ahsonnenschein/edm-fpga/Screenshot from EDM Controller.png

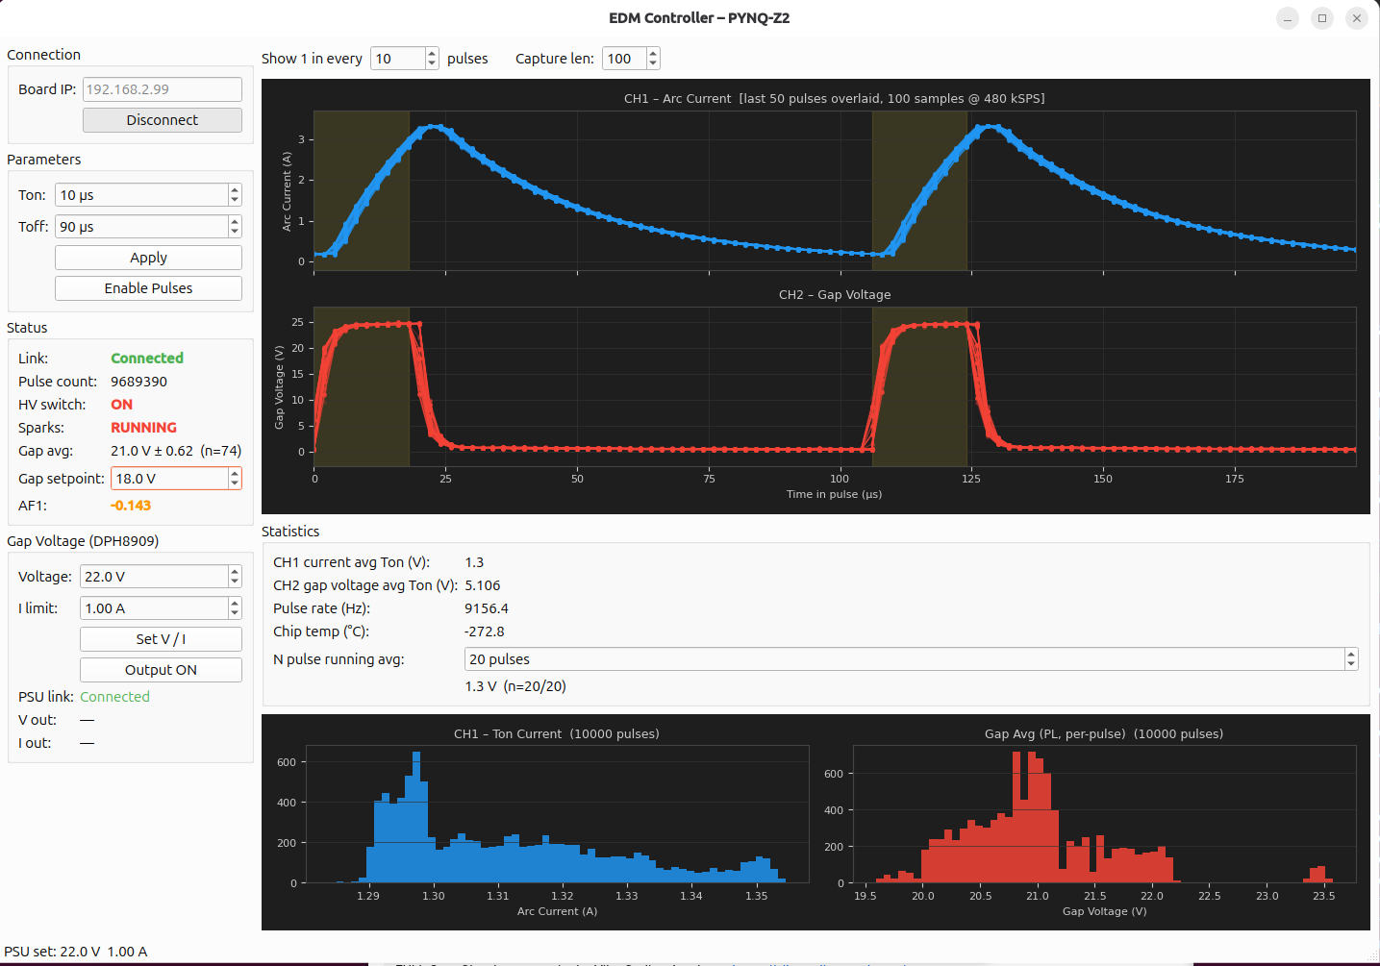
Screenshot from EDM Controller.png
