ahsonnenschein/edm-fpga/(commit log)

2026-03-14 Initial EDM FPGA controller for Red Pitaya STEMlab 125-14
    - edm_pulse_ctrl.v: Ton/Toff state machine, 1-cycle trigger output
    - waveform_capture.v: triggered ADC capture, AXI-Stream to DMA
    - axi_edm_regs.v: AXI-Lite register file (8 registers)
    - edm_top.v: top-level integration
    - create_project.tcl: Vivado block design (Zynq-7010, AXI DMA)
    - redpitaya_v1.xdc: pin constraints
    - modbus_server.py: Modbus TCP → AXI register bridge
    - waveform_manager.py: DMA reader, HDF5 save, matplotlib display
2026-03-14 Add simulation testbench — all tests passing
    - tb_edm_top.v: tests AXI-Lite R/W, pulse timing, waveform capture, disable
    - run_sim.tcl: xsim batch runner
    - synth_check.tcl: out-of-context synthesis check
    - Added `timescale 1ns/1ps to all RTL modules
    Simulation results:
    Ton = 10 cycles ✓
    Toff = 20 cycles ✓
    Waveform capture = 20 samples with correct TLAST ✓
    Disable stops pulse output ✓
    [axi_edm_regs.v, edm_pulse_ctrl.v, edm_top.v, tb_edm_top.v, waveform_capture.v]
2026-03-14 Add waveform streaming from RP to operator console (TCP port 5005)
    waveform_manager.py: WaveformServer broadcasts each decoded waveform
    frame to all connected consoles after every DMA transfer.
    operator_console.py: hardware mode now opens a second TCP connection
    to port 5005, receives frames, and feeds the live plots — simulation
    mode is unchanged.
    Wire protocol: [4-byte n_samples][n×float32 CH1][n×float32 CH2]
2026-03-28 Port EDM controller from Red Pitaya to PYNQ-Z2
    - Target changed to Zynq-7020 (xc7z020clg400-1), 100 MHz fabric clock
    - Replaced external 14-bit parallel ADC interface with XADC Wizard (AXI,
    VP/VN + VAUX1/Arduino A0 for gap voltage and arc current)
    - Added hv_enable input (Arduino D3) with 2-FF clock domain synchroniser;
    pulse output and pulse controller enable gated by hv_enable
    - Added warning lamp outputs (Arduino D4/D5/D6) with combinational
    green/orange/red logic based on hv_enable and enable register
    - Simplified AXI register map: removed waveform capture registers,
    added hv_enable read-only status; cycle counts scaled for 100 MHz
    - Replaced Red Pitaya XDC with pynq_z2.xdc for A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
    [axi_edm_regs.v, edm_top.v, pynq_z2.xdc, waveform_capture.v]
2026-03-28 Add PYNQ-Z2 operator console and board-side XADC server
    - xadc_server.py: runs on board as root, polls XADC + EDM registers
    at 200 Hz, streams JSON samples over TCP port 5006, accepts control
    commands (set_ton, set_toff, set_enable)
    - operator_console.py: rewritten for PYNQ-Z2; replaces Modbus+DMA stream
    with JSON TCP connection to xadc_server; displays rolling 5-second
    waveform of gap voltage (CH1) and arc current proxy (CH2); simulation
    mode generates realistic EDM pulse waveforms without board connection
    [operator_console.py, xadc_server.py]
2026-03-28 Update Modbus server for PYNQ-Z2 (LinuxCNC integration)
    Simplified register map — no waveform registers, updated for 100 MHz clock:
    - Holding: Ton_us (0), Toff_us (1), Enable (2)
    - Input: pulse_count_lo (0), pulse_count_hi (1), hv_enable (2)
2026-03-28 Add adaptive gap voltage feedback to Modbus server
    New holding registers for gap control thresholds (3=setpoint, 4=short, 5=open).
    New input registers: gap_voltage_avg (IIR-filtered XADC CH1 at 500 Hz) and
    arc_ok flag (1 when gap voltage is between short and open thresholds).
    LinuxCNC reads gap_voltage_avg vs gap_setpoint to implement adaptive feed control.
    [modbus_server.py]
2026-03-28 Port to PYNQ-Z2: 1 MSPS DMA capture, updated README
    - README: complete rewrite for PYNQ-Z2, removes all Red Pitaya references,
    documents XADC server, Modbus interface, operator console, and DMA waveform
    capture architecture
    - waveform_capture.v: rewritten to accept XADC Wizard DRP outputs (eoc/channel/do)
    instead of parallel ADC; captures ~500 kSPS per channel triggered by pulse_out
    - axi_edm_regs.v: add capture_len (0x14 RW) and waveform_count (0x18 RO) registers
    - edm_top.v: wire XADC DRP ports to waveform_capture; add AXI-Stream master output
    to DMA
    - create_project.tcl: add AXI DMA (S2MM), connect XADC DRP signals to edm_ctrl,
    DMA stream to PS HP0; DMA control at 0x40400000
    - x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
2026-03-29 Fix XADC ch2 zeros, remove simulation mode, add wiring docs
    XADC / sampling:
    - xadc_drp_reader.v rev 6: fix ADDR_CH2 from 0x19 (VAUX9, unconnected)
    to 0x11 (VAUX1); filter EOC trigger to Step-2 only (channel_out==0x11)
    - Corrects sample rate to 500 kSPS per channel (double-EOC hardware
    behaviour means valid {ch1,ch2} pairs land in every other DMA word)
    - xadc_server.py: extract both channels from even-indexed DMA words;
    remove interleave split that incorrectly read ch2 from zero odd words
    Operator console:
    - Remove simulation mode (SimSource class, sim checkbox, _run_sim, random import)
    - Stats panel: change "V peak" to mean-during-Ton (ch1 > 0 samples);
    add N-pulse running average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
    [axi_edm_regs.v, edm_top.v, operator_console.py, pynq_z2.xdc, waveform_capture.v, xadc_drp_reader.v, xadc_server.py]
2026-03-29 Use board physical pin labels (AR2-AR6, AR_AN0/1) in wiring section
    PYNQ-Z2 labels Arduino digital pins AR0-AR13 (not D2-D6) and
    analog pins AR_AN0-AR_AN5. Update README hardware table and
    wiring section to match what is printed on the board.
2026-03-29 Fix XADC header: 4 pins (VP, VN, GND, XVREF), note XVREF unused
2026-03-30 Fix HP0 stride bug, XADC read timing, and pin assignments
    Zynq HP0 drops every other 32-bit write — work around by outputting
    each sample twice on AXI-Stream and reading at stride 2 in software.
    Fix XADC "every other sample zero" by reading each result register
    only when channel_out confirms that channel just finished converting.
    Remap digital I/O from AR2-AR6 to AR0-AR4, add VAUX6 IOSTANDARD
    override for 3.3V bank, and fix capture length µs-to-samples conversion.
    [operator_console.py, pynq_z2.xdc, waveform_capture.v, xadc_drp_reader.v, xadc_server.py]
2026-03-30 Add sample FIFO to fix dropped pair_ready events during DMA backpressure
    Root cause: pair_ready is a single-cycle pulse (~500 kHz). When the AXI DMA
    deasserts tready during DDR burst writes, the capture FSM missed pulses and
    dropped samples — causing pulse edges to appear at random offsets in the
    capture buffer.
    Fix: 32-deep synchronous FIFO in waveform_capture.v buffers {ch1, ch2,
    pulse_state} on every pair_ready, decoupled from DMA timing. Also latches
    capture_len at trigger time to prevent mid-capture register changes from
    causing DMA hangs.
    Other changes:
    - Swap CH1/CH2 labels: CH1=arc current (VP/VN), CH2=gap voltage (VAUX6)
    - Fix XADC channel: VAUX1→VAUX6 for A0/A1 pins on PYNQ-Z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
    [edm_top.v, operator_console.py, waveform_capture.v, xadc_server.py]
2026-03-30 UART to Pmod B, MMIO PSU driver, fixed-rate capture, Modbus server fixes
    - Move UART1 pins from RPi header (V6/Y6) to Pmod B (W14/Y14) to free
    RPi header for future expansion
    - Replace pyserial DPH8909 driver with direct MMIO access to PS UART1
    registers (0xE0001000), bypassing broken device-tree overlay
    - Use w20 combined command for voltage+current to avoid dropped commands
    at 9600 baud
    - Add SLCR FPGA reset before overlay load to prevent bus errors and
    kernel panics during PL reprogramming
    - waveform_capture rev 9: replace pair_ready-driven sampling with
    fixed-rate sample_tick (every 208 clocks = 480.769 kSPS) to eliminate
    timing gaps from XADC calibration cycles that caused t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
    [diag_timestamp.py, modbus_server.py, operator_console.py, pynq_z2.xdc, test_modbus.py, waveform_capture.v, xadc_server.py]
2026-03-30 Revert to rev 8, cap_len=47 workaround, add investigation report
    - Revert waveform_capture.v to rev 8 (pair_ready based) after rev 9
    (fixed-rate sample_tick) failed to fix the first-period anomaly and
    had stability issues (stuck after first capture)
    - Set default capture_len to 47 (< 48 = one period) so the second
    pulse never appears in captured data
    - Remove DMA pre-reset before overlay load (bus error on fresh boot)
    - Add comprehensive investigation report in docs/
    [waveform_capture.v, xadc_server.py]
2026-03-31 WIP: DMA interrupt connection, PYNQ DMA driver compatibility
    - Add X_INTERFACE_INFO/PARAMETER attributes to edm_top.v for AXI-Stream
    clock association (fixes BD 41-967 warning)
    - Attempt to connect DMA s2mm_introut to PS IRQ_F2P in create_project.tcl
    (validate_bd_design creates the pin, but HWH metadata still shows
    PCW_USE_FABRIC_INTERRUPT=0 — Vivado PS7 IP limitation)
    - Rewrite xadc_server.py to use PYNQ DMA API with polling fallback
    - Add DPH8909 MMIO UART driver and w20 combined command
    - Root cause of DMA failure: PYNQ auto-detects axi_dma IP from HWH,
    installs its driver which blocks raw MMIO, and requires interrupt
    for wait() — but interrupt connection doesn't propagate t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
    [edm_top.v, waveform_capture.v, xadc_server.py]
2026-03-31 Hidden DMA from PYNQ, raw MMIO approach — DMA reset stuck
    - Modified HWH (edm_pynq_nodma.hwh) hides DMA from PYNQ's IP detection
    by changing MODTYPE and VLNV to custom values
    - xadc_server.py swaps HWH during overlay load so PYNQ doesn't install
    its DMA driver, enabling raw MMIO access
    - DMA DMACR register reads 0x00010006 (Reset bit stuck at 1) regardless
    of what is written — DMA cannot be started
    - Root cause: DMA reset not clearing after overlay load, possibly related
    to axi_resetn/FCLK_RESET0_N connection or GUI IRQ change side effect
    - Added X_INTERFACE attributes to edm_top.v for AXI-Stream clock
    association (Verilog pragmas)
    - IRQ_F2P now physically connected in bitstrea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
    [xadc_server.py]
2026-03-31 Update lessons learned (#18-20): tready coupling, PS7 IRQ via GUI, PYNQ DMA
    - #18: Never qualify trigger on m_axis_tready — root cause of first-period
    anomaly. Decoupled BRAM-based capture architecture planned.
    - #19: PCW_USE_FABRIC_INTERRUPT can only be set via Vivado GUI, not TCL
    - #20: PYNQ auto-detects AXI DMA and blocks raw MMIO access
2026-03-31 Rev 10 decoupled BRAM capture, raw MMIO DMA, lessons 21
    - waveform_capture.v rev 10: trigger starts BRAM capture independently
    of m_axis_tready, then streams to DMA after all samples collected.
    Fixes first-period anomaly (trigger no longer coupled to DMA state).
    - xadc_server.py: raw /dev/mem DMA control with waveform_count polling.
    Modified HWH hides DMA from PYNQ to prevent driver crashes.
    - Lesson #20 updated: PYNQ DMA object access can crash process/board
    - Lesson #21: overlay reload crashes FPGA manager, needs power cycle
    [waveform_capture.v, xadc_server.py]
2026-03-31 Working: PYNQ DMA API + wfc polling, clean server rewrite
    - Complete xadc_server.py rewrite using PYNQ DMA API with
    waveform_count polling (no interrupt needed)
    - First transfer after boot may timeout — subsequent ones work
    - Uses real HWH (not modified) — PYNQ DMA driver required
    - Must be first overlay load after power cycle
    - PSU via MMIO UART on Pmod B with w20 combined command
    - Rev 7 RTL (pair_ready based capture)
    - Lessons learned #22-23: HWH modification doesn't work, DMA arm order
    - Tested: 20 bursts received, first_period mean=48.0
    [edm_top.v, waveform_capture.v, xadc_server.py]
2026-03-31 Fix buffer size (must match capture_len), DMA still intermittent
    - Buffer must match capture_len * 2 exactly — MAX_CAPTURE sized buffer
    causes DMA to never complete (tready drops)
    - PYNQ DMA channel recovery is intermittent — sometimes works on fresh
    boot, sometimes stays "not idle" permanently
    - Capture_len fixed at 100 (changing requires restart + power cycle)
    - Lessons 22-23 added
    [xadc_server.py]
2026-03-31 FIXED: Rev 11 — DMA-free AXI-Lite BRAM readout, first-period anomaly solved
    The first-period anomaly (std=14, varying 35-78 samples) is FIXED.
    New measurement: min=48, max=49, mean=48.1, std=0.3.
    Root cause confirmed: coupling capture trigger to m_axis_tready made
    the capture start on a random trigger relative to DMA arm timing.
    Fix: eliminate AXI DMA entirely. Waveform capture stores samples in
    local BRAM (triggered independently of DMA), software reads BRAM
    via AXI-Lite register window at offset 0x800.
    Changes:
    - waveform_capture.v rev 11: decoupled BRAM capture, BRAM read port
    for AXI-Lite access, AXI-Stream tied off
    - axi_edm_regs.v: widened to 12-bit address (4KB), BRAM read at 0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
    [axi_edm_regs.v, edm_top.v, waveform_capture.v, xadc_server.py]
2026-03-31 Lessons 24-25: eliminate DMA, VP/VN grounding
    - #24: AXI-Lite BRAM readout eliminates all DMA reliability issues
    - #25: XADC VN must be grounded, not floating (causes DC offset/inversion)
2026-03-31 Increase burst overlay to 20 traces with quadratic fade
    - 20 overlaid traces (was 10)
    - Quadratic alpha: oldest at 5% opacity, newest at 100%
    - Thinner old traces (0.3 lw) vs thick newest (1.2 lw)
    - Fix sample rate label: 480 kSPS (was 500)
    [operator_console.py]
2026-03-31 Increase trace overlay to 50 for richer persistence display
2026-03-31 Rev 12: trigger-synchronous sampling, lesson #26, memory update
    - waveform_capture.v rev 12: fixed-rate sample_tick synchronized to
    trigger edge eliminates ±1 sample inter-trace jitter
    - Lesson #26: use trigger-synchronous sampling for zero jitter
    - Updated project memory and bug report (both issues RESOLVED)
    - README now has 26 lessons learned
    [waveform_capture.v]
2026-03-31 Gap voltage accumulator (PL) + histogram display + calibration
    - edm_top.v: per-pulse gap voltage accumulator (sum/count during Ton)
    - axi_edm_regs.v: new registers at 0x28 (gap_sum) and 0x2C (gap_count)
    - xadc_server.py: reads gap_avg, sends in status stream; calibrated
    CH1_PROBE=3.333 (2A=2.0), CH2_RANGE=198.0 (20V=20.0)
    - operator_console.py: histogram shows per-pulse gap voltage from PL
    accumulator + per-burst arc current; 10K entry rolling buffer
    - waveform_capture.v: reverted to pair_ready sampling (rev 11 base)
    [axi_edm_regs.v, edm_top.v, operator_console.py, waveform_capture.v, xadc_server.py]
2026-03-31 Gap voltage batch + stats: 100 Hz poll, 10 Hz stats, 1 Hz histogram batch
    - Server polls PL gap accumulator at 100 Hz
    - gap_stats (avg, std, n) sent at 10 Hz for real-time display
    - gap_batch (individual values) sent every second for histogram
    - Operator console: gap_avg label in status panel, histogram from batches
    - Both signals connected through WorkerSignals
2026-03-31 Add Vset, AF1 adaptive feed parameter, Modbus IR[5]
    - Operator console: Gap setpoint (Vset) spinbox, AF1 display with
    color coding (green=on target, orange=close, red=off)
    - AF1 = (Vset - Vavg) / Vavg — computed from PL gap accumulator
    - Modbus input register IR[5]: AF1 × 1000 as signed 16-bit integer
    for LinuxCNC adaptive feed control via mb2hal
    - modbus_server.py: uses PL gap accumulator (REG_GAP_SUM/COUNT)
    instead of software IIR filter
    - xadc_server.py: stores gap_avg_latest for cross-thread access
2026-03-31 Fix: remove stale add_sample call on histogram widget
    [operator_console.py]
2026-03-31 Update README: register map, AF1, Modbus, architecture changes
    - Updated top-level description: 480 kSPS, BRAM readout, no DMA
    - Register map: added gap_sum/gap_count (0x28/0x2C), BRAM window (0x800+)
    - Added Adaptive Feed Control section with AF1 formula
    - Modbus: updated IR[3] to PL accumulator, added IR[5] AF1
    - Fixed hardware table: PSU on Pmod B, CH1 opto-isolated shunt
2026-04-01 Invert HV enable (active-LOW switch), rename to Operator HV Enable
    [edm_top.v, operator_console.py]
2026-04-01 Fix docs: gap voltage is on A2, not A0 (VAUX6 maps to J1 pin A2)
    [pynq_z2.xdc, xadc_drp_reader.v]
2026-04-01 Safety: auto-disable PSU output when enable=0
    Prevents stored charge on the gap when pulses stop. The DPH8909
    output is automatically turned off whenever the operator disables
    sparks, removing the continuous bias voltage from the wire.
    [xadc_server.py]
2026-04-01 Add delay to PSU safety interlock to avoid serial collision
    [xadc_server.py]
2026-04-01 Bold disconnect warning: red border, PSU safety reminder
    When board connection is lost, the console shows a large red warning
    label, red window border, and status bar message reminding the operator
    to check the DPH8909 front panel (PSU may still be active).
2026-04-01 UX improvements: separate ON/OFF buttons + indicators, PSU parse fix
    - Sparks: separate "Start Sparks" / "Stop Sparks" buttons with
    ON/OFF state indicator (red=on, gray=off)
    - PSU output: separate "Turn ON" / "Turn OFF" buttons with indicator
    - Fixed PSU readback parse error: trailing period in DPH8909 response
    ("2000.") caused int() to fail — now stripped
    - Disconnect warning: shown in window title bar for visibility
    - PSU readback errors now logged instead of silently swallowed
    [operator_console.py, xadc_server.py]
2026-04-01 Safety: force enable=0 and PSU off at server startup
    Prevents stale enable=1 from previous crash from turning on PSU
    when server restarts.
    [xadc_server.py]
2026-04-01 PSU output indicator tracks actual V/I readings, not button state
2026-04-01 Fix PSU ON threshold: require Vout>1V AND Iout>50mA to avoid residual readings
    [operator_console.py]
2026-04-01 Safety: PSU auto-off when Operator HV Enable switch is flipped OFF
    The 200 Hz status loop monitors hv_enable. When the physical switch
    goes OFF, the server immediately disables the DPH8909 output,
    removing all voltage from the gap. This prevents 40V+ remaining on
    the gap through the pulseboard's off-resistance.
    [xadc_server.py]
2026-04-01 Move connection status + buttons to Connection group, remove duplicate
    Separate Connect/Disconnect buttons with status indicator all in the
    Connection group box, right under Board IP. Removed duplicate link
    label from Status group.
2026-04-01 Replace PYNQ MMIO with direct /dev/mem access, fix PSU safety interlock
    PYNQ Device discovery broken on current kernel — use mmap /dev/mem
    directly via DevMemMMIO class (no PYNQ dependency for MMIO).
    PSU now tracks both hv_enable AND enable: turns ON/OFF bidirectionally.
    [xadc_server.py]
2026-04-03 Add CLAUDE.md with comprehensive project context
    Architecture, register map, pin assignments, critical lessons learned,
    build/deploy process, calibration constants, known issues, and pending work.
2026-04-03 Add DPH8909 PSU wiring and UART details to CLAUDE.md
2026-04-03 Track PSU comms health; show UNKNOWN state when serial fails
    - Add psu_comms_ok field to xadc_server status stream (True after first
    successful readback, False on any exception)
    - Throttle PSU readback error logging (first 3 then every 20th)
    - Add UART1 local loopback self-test at startup to confirm MMIO TX path
    - Default PSU state label to UNKNOWN (orange) instead of OFF to avoid
    false safe-state indication before comms are confirmed
    - Show COMMS FAIL + UNKNOWN when psu_comms_ok=False in console
    [operator_console.py, xadc_server.py]
2026-04-12 Fix unicode characters in xadc_server.py causing ASCII codec error
    Replace em-dash (U+2014) and right-arrow (U+2192) characters with ASCII
    equivalents in print strings and comments. These caused:
    PSU not available: 'ascii' codec can't encode character '\u2014' in position 18
    when the UART1 loopback test ran on the PYNQ board.
    [xadc_server.py]
2026-04-12 docs: document boot crash root cause and fix in CLAUDE.md
    Jupyter loads base.bin ~40s into boot, overwriting the EDM bitstream.
    Fix is ExecStartPre=/bin/sleep 45 in edm.service. Also documents dirty
    filesystem issue after kernel panics, serial console workaround, USB 5V
    power adequacy, and deploy/edm.service copy commands.
2026-04-13 fix: correct PL clock frequency from 100MHz to 62.5MHz
    PYNQ Overlay() sets FCLK0 to 62.5MHz (IO PLL 1000MHz / 4 / 4) via SLCR,
    not the 100MHz the bitstream was synthesized for. This caused Ton/Toff to
    run 1.6x too long (10us set -> 16us actual). Fix uses CYCLES_PER_US=62.5
    constant for all cycle<->microsecond conversions. Also reverts the failed
    Clocks.fclk0_mhz=100 approach which locked up the board.
    [xadc_server.py]
2026-04-13 fix: PSU output indicator uses voltage only, not current
    Current check (>50mA) caused false 'Off' with pulsed EDM loads -- the
    PSU ammeter sees only average current which is low at low duty cycles.
    Voltage alone (>1V) reliably indicates whether the PSU output is enabled.
    [operator_console.py]
2026-04-13 fix: add PULLUP to hv_enable pin, remove dead sample_tick counter
    Floating hv_enable input (AR1/U12) picks up FPGA switching noise at
    ~3us after trigger (from pair_ready gap accumulator activity), glitching
    hv_enable_sync and causing brief dips on pulse_out. Fix: PULLUP=true
    in XDC keeps pin defined HIGH when switch is in enabled position.
    Also removes dead sample_tick counter in waveform_capture (SAMPLE_PERIOD
    208 cycles = 3.3us, firing right after trigger but never used by the FSM).
    Both changes require a bitstream rebuild. Immediate workaround: 10kohm
    pull-up resistor from AR1 to 3.3V on Arduino header.
    [pynq_z2.xdc, waveform_capture.v]
2026-04-13 docs: add lessons learned from timing/clock/PSU debugging session
    Documents: hv_enable floating input glitch mechanism, PL clock at 62.5MHz
    (not 100MHz) and why Clocks.fclk0_mhz=100 hangs the board, PSU output
    indicator voltage-only threshold for pulsed EDM loads.
2026-04-17 Update CLAUDE.md with QMTech board info, PetaLinux Docker build process
    Add QMTech Zynq-7010 board specs, pin assignments, AD9226 ADC details.
    Document PetaLinux build issues: pseudo fails on Docker volume mounts,
    Ubuntu 24.04 apparmor blocks pseudo, must build inside container filesystem.
    Add create_qmtech_project.tcl for Vivado block design.
2026-04-18 Add AD9226 ADC capture module and QMTech Zynq-7010 EDM top-level
    - ad9226_capture.v: dual-channel 12-bit parallel ADC interface with
    25 MHz clock generation (100 MHz / 4)
    - edm_top_qmtech.v: EDM controller for QMTech board, replaces XADC
    with AD9226 capture, otherwise identical to PYNQ-Z2 version
    - create_qmtech_project.tcl: updated with EDM AXI slave, AD9226 ports,
    AXI interconnect, and preliminary pin constraints (need AD9226 board
    pinout to finalize)
    Pin constraints are placeholders — will be updated when AD9226 board
    pinout is confirmed.
    [ad9226_capture.v, edm_top_qmtech.v]
2026-04-19 Update QMTech pin constraints with confirmed AD9226 pinout
    AD9226 2x14 connector maps to JP2 pins 1-30 with A1→JP2-3.
    EDM I/O (pulse, HV enable, lamps) on JP5 BANK35 pins.
    Build still has placement errors — DDR/FIXED_IO interface
    handling needs work for Vivado 2023.2.
2026-04-19 QMTech Vivado build SUCCEEDS: PS7-only BD + Verilog top-level
    Fixed the 128 unplaced I/O issue by separating PS7 into its own block
    design (DDR/FIXED_IO handled internally by apply_bd_automation) and
    wrapping it from a Verilog top-level alongside EDM + AD9226 logic.
    Resource utilization on XC7Z010:
    - LUTs: 4121/17600 (23%)
    - Registers: 13514/35200 (38%)
    - Bonded IOB: 44/100 (44%)
    - BRAM: 0/60 (will be used by waveform capture)
    Bitstream generated at impl_1/top.bit, XSA at edm_qmtech.xsa.
    Tested runtime loading via /dev/xdevcfg on vendor Linux — works.
    [qmtech_top.v]
2026-04-19 Fix QMTech build: EDM inside BD with AXI interconnect, 4-bit MII
    - Moved EDM IP inside block design with proper AXI interconnect
    (handles AXI3→AXI4-Lite protocol conversion)
    - Fixed MII port widths: 4-bit external ports with xlslice/xlconcat
    for 8-bit GMII adaptation (was causing 8 unplaced I/O)
    - Build succeeds: 23% LUTs, 38% registers, 44% I/O
    Root cause of AXI crash identified: vendor's FSBL has
    PCW_FCLK_CLK0_BUF=FALSE — FCLK not buffered to PL.
    Board uses external 50MHz PL crystal instead. Our design
    needs FCLK from PS. Still investigating fix.
2026-04-19 QMTech: proc_sys_reset for PL initialization, root cause analysis
    Root cause of AXI crash: vendor PS7 has FCLK_CLK0_BUF=FALSE and
    EN_RST0_PORT=0. Added proc_sys_reset to generate clean power-on
    reset. However, the real issue is that accessing AXI GP0 (0x43C00000)
    with NO slave causes an AXI DECERR → kernel panic on Zynq.
    This happens because:
    1. Runtime bitstream loading via xdevcfg works (Ethernet survives)
    2. But AXI access crashes because GP0 has no slave during reconfiguration
    3. Even on vendor bitstream, GP0 access at 0x43C00000 crashes
    4. U-Boot fpga load command has syntax issues on vendor U-Boot
    5. Our PetaLinux FSBL doesn't boot on this board (Vivado 2023.2 incompatible)
    The PYN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
2026-04-19 QMTech: FSBL debug — vendor PLL values don't fix boot
    Rebuilt FSBL with vendor's exact HWH (confirmed vendor PLL value
    0x00113220 present in FSBL binary). Board still doesn't boot.
    The issue is NOT the PLL parameters — it's something fundamental
    in the Vivado 2023.2 FSBL code vs the 2018.3 code. The FSBL
    doesn't even produce UART output, suggesting it crashes before
    ps7_init runs.
    Remaining options:
    1. Install Vivado 2018.3 and build FSBL with that version
    2. Use JTAG to debug FSBL execution
    3. Use vendor BOOT.BIN + runtime bitstream loading (works for
    Ethernet but AXI GP0 access crashes without proper PL slave)
    4. Use vendor BOOT.BIN + U-Boot fpga load (vendor U-Boot fpga
    comman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
